peedrooh/seebum/production/seebum_2024-01-31_16-46-21/bom.csv

Designator | Footprint | Quantity | Value | LCSC Part #
C201, C204, C207 | 0805 | 3 | 10uF
C202, C205, C206 | 0805 | 3 | 0,1uF
C213, C214 | 0805 | 2 | 1uF
C215, C312 | 0805 | 2 | 100nF
C301, C302, C304, C306, C307, C308, C310, C311 | 0805 | 8 | 0.1uF
C303, C305 | CP_EIA-3528-21_Kemet-B | 2 | 10uF | C163225
C309 | 0805 | 1 | 2.2nF
C402 | 0805 | 1 | 22nF | C107137
C403, C411 | 0805 | 2 | 0u1F | C89258
C405, C406, C407, C408 | 0805 | 4 | 47uF | C7472975
C409, C410 | 1206 | 2 | 2u2F | C577211
D201 | 0805 | 1 | RED
D204, D205 | D_SOD-123 | 2 | D_Schottky | C2891704
D210 | 0805 | 1 | BLUE
D211 | 0805 | 1 | GREEN
D401 | D_PowerDI-5 | 1 | PDS760-13 | C96113
H101, H102, H103, H104 | MountingHole_2.7mm_M2.5_Pad_Via | 4 | MountingHole
J101 | AMASS_XT30PW-M_1x02_P2.50mm_Horizontal | 1 | Conn_01x02_Pin
J102 | PinHeader_2x03_P2.54mm_Vertical | 1 | Conn_01x06_Pin
J201, J202 | USB_C_Receptacle_G-Switch_GT-USB-7010ASV | 2 | USB_C_Receptacle_USB2.0
J301, J306 | JST_PH_B3B-PH-SM4-TB_1x03-1MP_P2.00mm_Vertical | 2 | Conn_01x03_Socket
J302, J304 | JST_PH_S2B-PH-SM4-TB_1x02-1MP_P2.00mm_Horizontal | 2 | Conn_01x02_Socket
J303, J305 | JST_PH_S6B-PH-SM4-TB_1x06-1MP_P2.00mm_Horizontal | 2 | Conn_01x06_Socket | C265405
J307 | JST_PH_B8B-PH-SM4-TB_1x08-1MP_P2.00mm_Vertical | 1 | Conn_01x08_Socket
J308 | JST_PH_B4B-PH-SM4-TB_1x04-1MP_P2.00mm_Vertical | 1 | Conn_01x04_Socket
J501 | PinSocket_2x20_P2.54mm_Vertical | 1 | GPIO
JP201, JP202 | SolderJumper-2_P1.3mm_Bridged_RoundedPad1.0x1.5mm | 2 | SolderJumper_2_Bridged
JP203, JP204, JP205, JP206, JP301 | SolderJumper-2_P1.3mm_Open_TrianglePad1.0x1.5mm | 5 | SolderJumper_2_Open
L401 | L_10.4x10.4_H4.8 | 1 | 8u2 | C2847563
Q101 | SO-8_5.3x6.2mm_P1.27mm | 1 | AO4407 | C469397
Q201, Q202 | SOT-23 | 2 | Q_NPN_BCE | C49581
R101 | 0805 | 1 | 2k | C17604
R102, R103, R104, R105, R301 | 0805 | 5 | 4k7
R201, R204, R205, R303 | 0805 | 4 | 1K
R202, R203 | 0805 | 2 | 10k
R212, R213, R214, R215 | 0805 | 4 | 5k1
R302 | 0805 | 1 | 330
R401 | 0805 | 1 | 84k5 | C17842
R402 | 0805 | 1 | 100k | C2763792
R403 | 0805 | 1 | 17k8 | C413729
SW101 | 5Amp_Switch | 1 | SW_DPDT_x2 | C2884744
SW201, SW202 | SW_SPST_B3U-1000P | 2 | SW_MEC_5E | C720477
U201 | SOT-223-3_TabPin2 | 1 | AMS1117-3.3
U202 | ESP32-S3-WROOM-1 | 1 | ESP32-S3-WROOM-1 | C2913205
U204 | TQFN-16-1EP_3x3mm_P0.5mm_EP1.23x1.23mm | 1 | CH343P | C2846043
U301, U302 | SSOP-24_5.3x8.2mm_P0.65mm | 2 | TB6612FNG
U303 | InvenSense_QFN-24_4x4mm_P0.5mm | 1 | MPU-6050
U304 | SOT-23-5 | 1 | 74LVC1G126 | C7834
U401 | Texas_R-PDSO-G8_EP2.95x4.9mm_Mask2.4x3.1mm_ThermalVias | 1 | LMR14050 | C155484
