peedrooh/seebum/3D Models/5Amp_Switch.stp

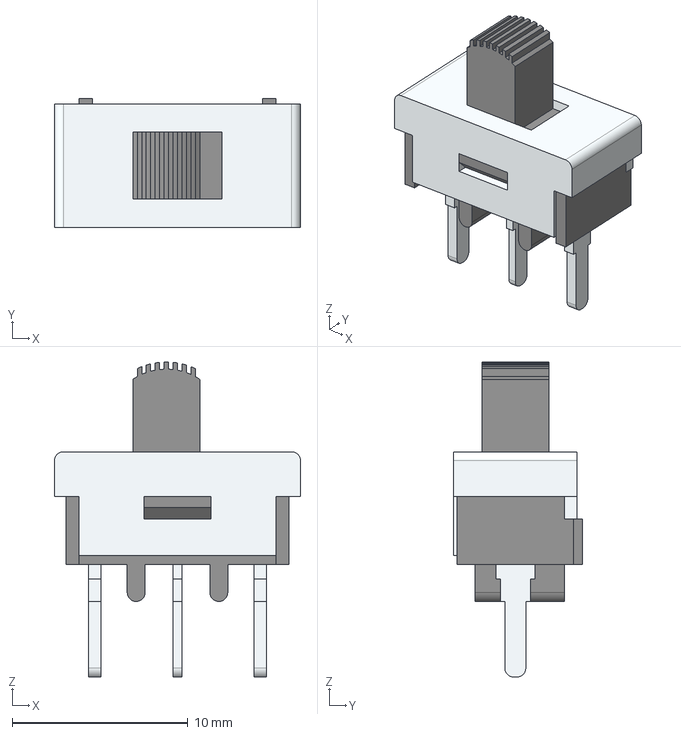
[picture p1: CAD file, 2024-02-03]
3D Models/5Amp_Switch.stp
14.0 x 7.32 x 17.9 mm
