peedrooh/seebum/3D Models/Amass_XT30PW-M_pcb solder.stp

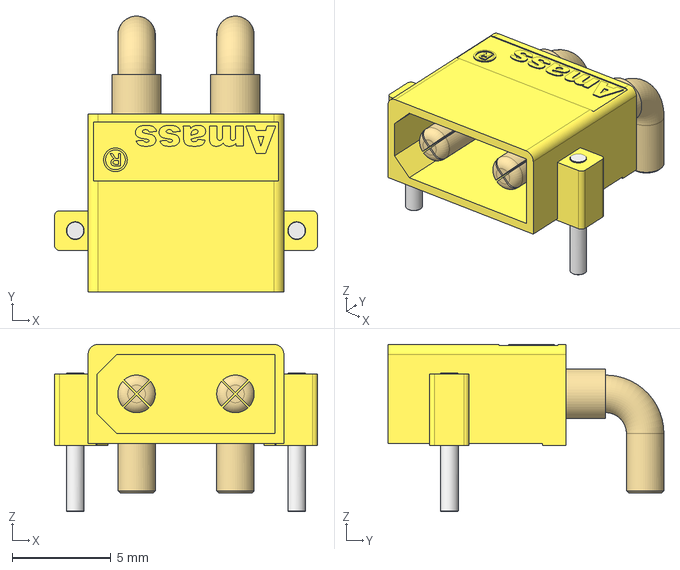
[picture p2: CAD file, 2024-02-03]
3D Models/Amass_XT30PW-M_pcb solder.stp
13.3 x 13.9 x 8.45 mm
