peedrooh/seebum/seebum.kicad_pcb

## KiCad design seebum.kicad_pcb (2024-02-03)

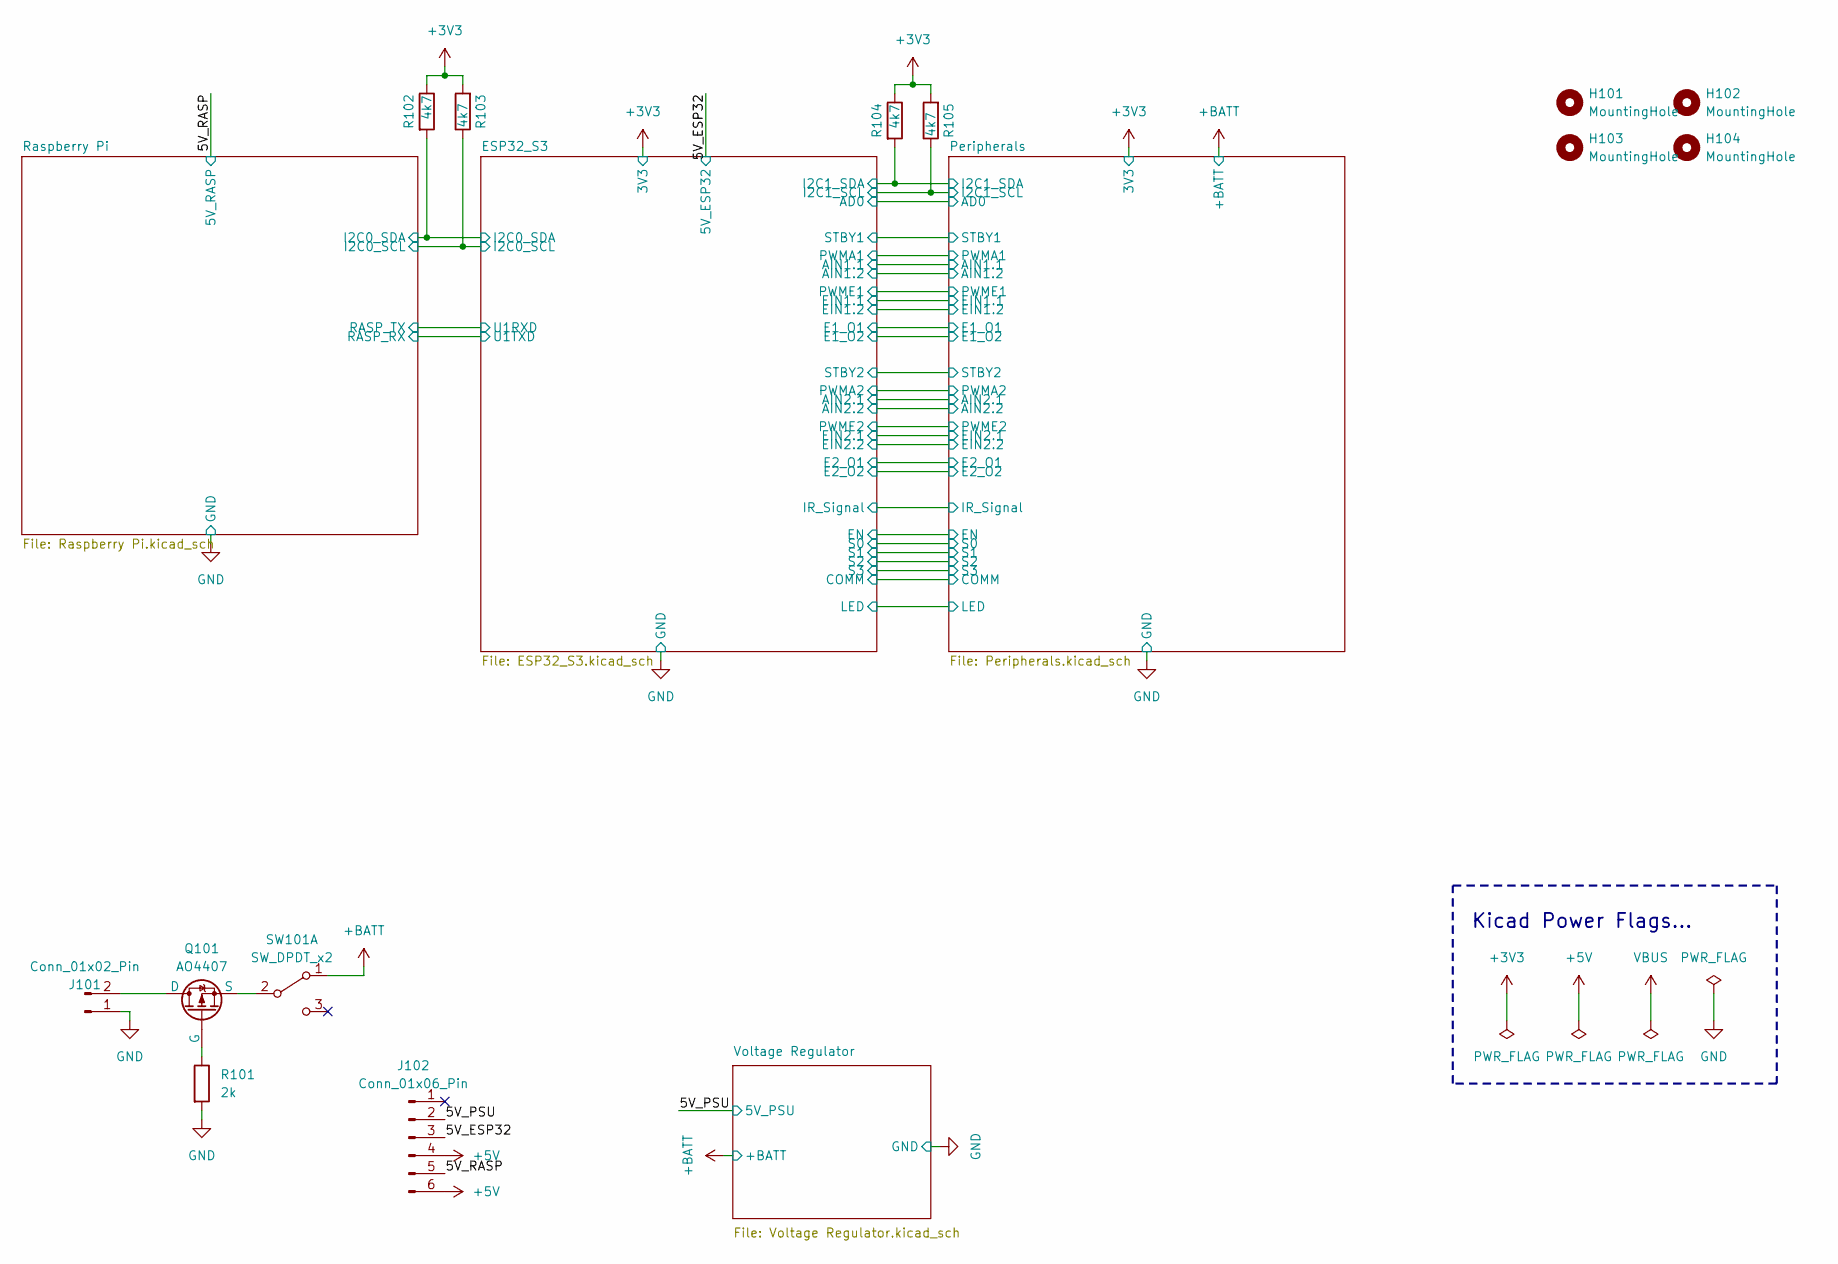
[picture p3: schematic seebum.kicad_sch]

Parts:
H101, H102, H103, H104: MountingHole; MountingHole_2.7mm_M2.5_Pad_Via
J101: Conn_01x02_Pin; AMASS_XT30PW-M_1x02_P2.50mm_Horizontal
J102: Conn_01x06_Pin; PinHeader_2x03_P2.54mm_Vertical
Q101: AO4407; SO-8_5.3x6.2mm_P1.27mm; LCSC C469397
R101: 2k; R_0805_2012Metric; LCSC C17604
R102, R103, R104, R105: 4k7; R_0805_2012Metric; LCSC C17673
SW101: SW_DPDT_x2; 5Amp_Switch; LCSC C2884744

Connections:
+3V3: R102.1, R103.2, R104.1, R105.2; also elsewhere on the board
+5V: J102.4, J102.6; also elsewhere on the board
+BATT: SW101.1 (A); also elsewhere on the board
/5V_ESP32: J102.3; also elsewhere on the board
/5V_PSU: J102.2; also elsewhere on the board
/5V_RASP: J102.5; also elsewhere on the board
/ESP32_S3/GPIO6: R102.2; also elsewhere on the board
/ESP32_S3/GPIO7: R103.1; also elsewhere on the board
/Peripherals/SCL: R105.1; also elsewhere on the board
/Peripherals/SDA: R104.2; also elsewhere on the board
GND: J101.1, R101.2; also elsewhere on the board
unnamed: J101.2, Q101.1 (D)
unnamed: Q101.2 (G), R101.1
unnamed: Q101.3 (S), SW101.2 (B)

Notes on the sheet:
Kicad Power Flags...

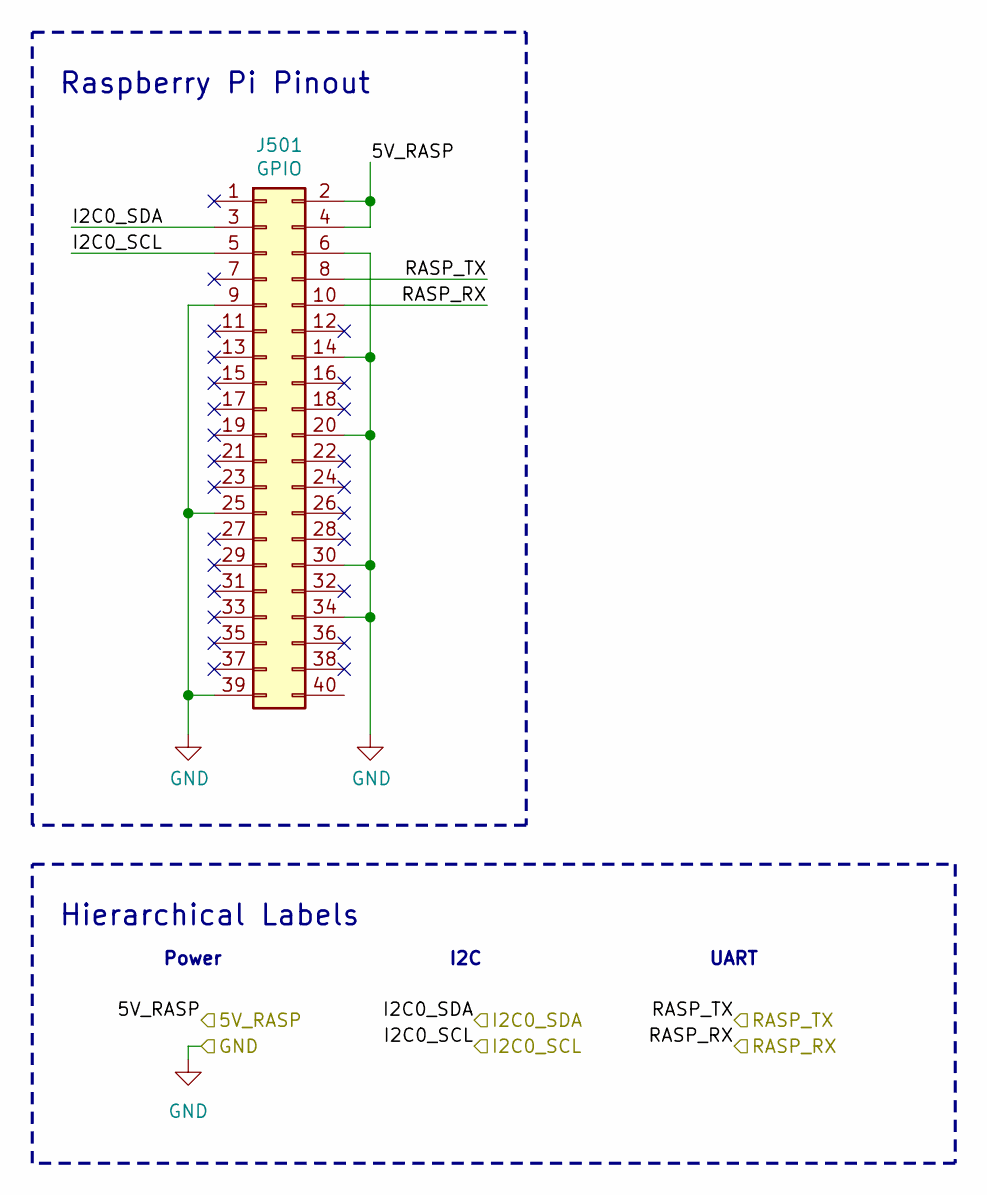
[picture p4: schematic Raspberry Pi.kicad_sch, Rapberry Pi]

Parts:
J501: GPIO; PinSocket_2x20_P2.54mm_Vertical

Connections:
/5V_RASP: J501.2, J501.4; also elsewhere on the board
/ESP32_S3/GPIO6: J501.3; also elsewhere on the board
/ESP32_S3/GPIO7: J501.5; also elsewhere on the board
/ESP32_S3/GPIO17: J501.10; also elsewhere on the board
/ESP32_S3/GPIO18: J501.8; also elsewhere on the board
GND: J501.6, J501.9, J501.14, J501.20, J501.25, J501.30, J501.34, J501.39; also elsewhere on the board

Notes on the sheet:
I2C
Hierarchical Labels
UART
Power
Raspberry Pi Pinout

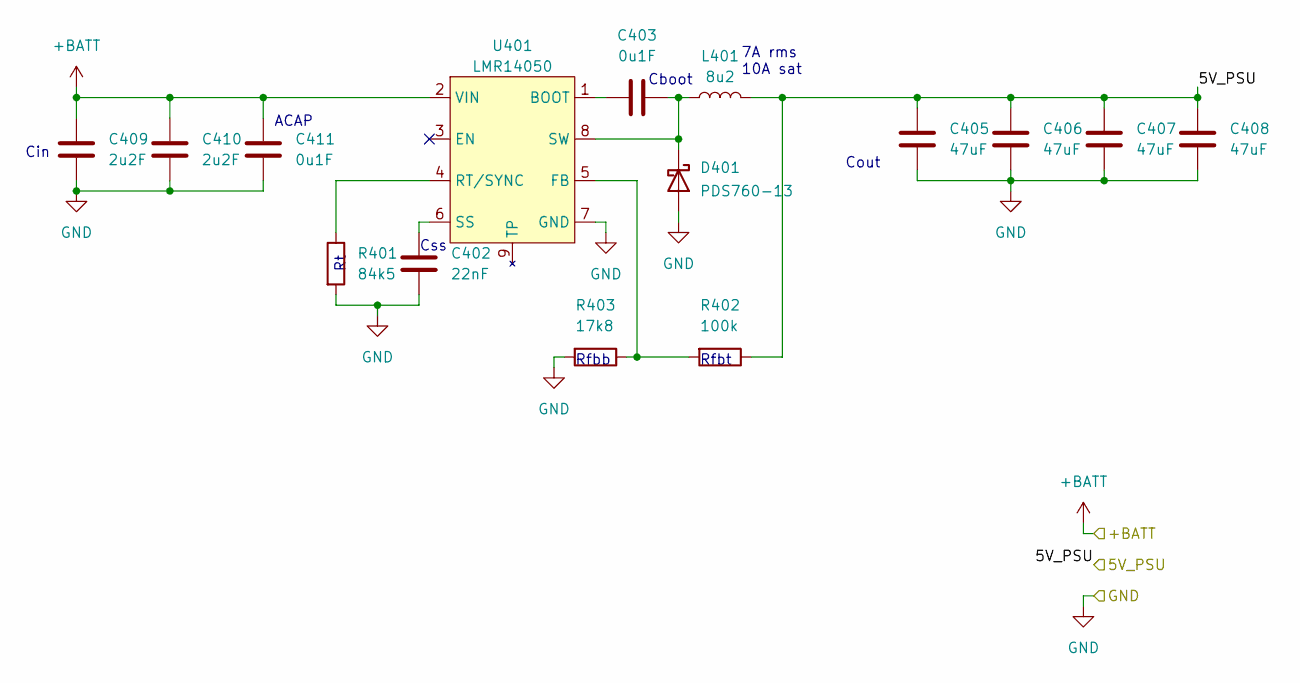
[picture p5: schematic Voltage Regulator.kicad_sch, Power Regulation]

Parts:
C402: 22nF; C_0805_2012Metric; LCSC C107137
C403, C411: 0u1F; C_0805_2012Metric; LCSC C89258
C405, C406, C407, C408: 47uF; C_0805_2012Metric; LCSC C7472975
C409, C410: 2u2F; C_1206_3216Metric; LCSC C577211
D401: PDS760-13; D_PowerDI-5; LCSC C96113
L401: 8u2; L_10.4x10.4_H4.8; LCSC C2847563
R401: 84k5; C_0805_2012Metric; LCSC C17842
R402: 100k; R_0805_2012Metric; LCSC C2763792
R403: 17k8; C_0805_2012Metric; LCSC C413729
U401: LMR14050; Texas_R-PDSO-G8_EP2.95x4.9mm_Mask2.4x3.1mm_ThermalVias; LCSC C155484

Connections:
+BATT: C409.1, C410.1, C411.1, U401.2 (VIN); also elsewhere on the board
/5V_PSU: C405.1, C406.1, C407.1, C408.1, L401.2, R402.1; also elsewhere on the board
GND: C402.2, C405.2, C406.2, C407.2, C408.2, C409.2, C410.2, C411.2, D401.2 (A), R401.2, R403.2, U401.7 (GND); also elsewhere on the board
unnamed: C403.2, D401.1 (K), L401.1, U401.8 (SW)
unnamed: C403.1, U401.1 (BOOT)
unnamed: R402.2, R403.1, U401.5 (FB)
unnamed: R401.1, U401.4 (RT/SYNC)
unnamed: C402.1, U401.6 (SS)

Notes on the sheet:
7A rms 10A sat
Cout
Cboot
ACAP
Cin
Css
Rfbt
Rfbb

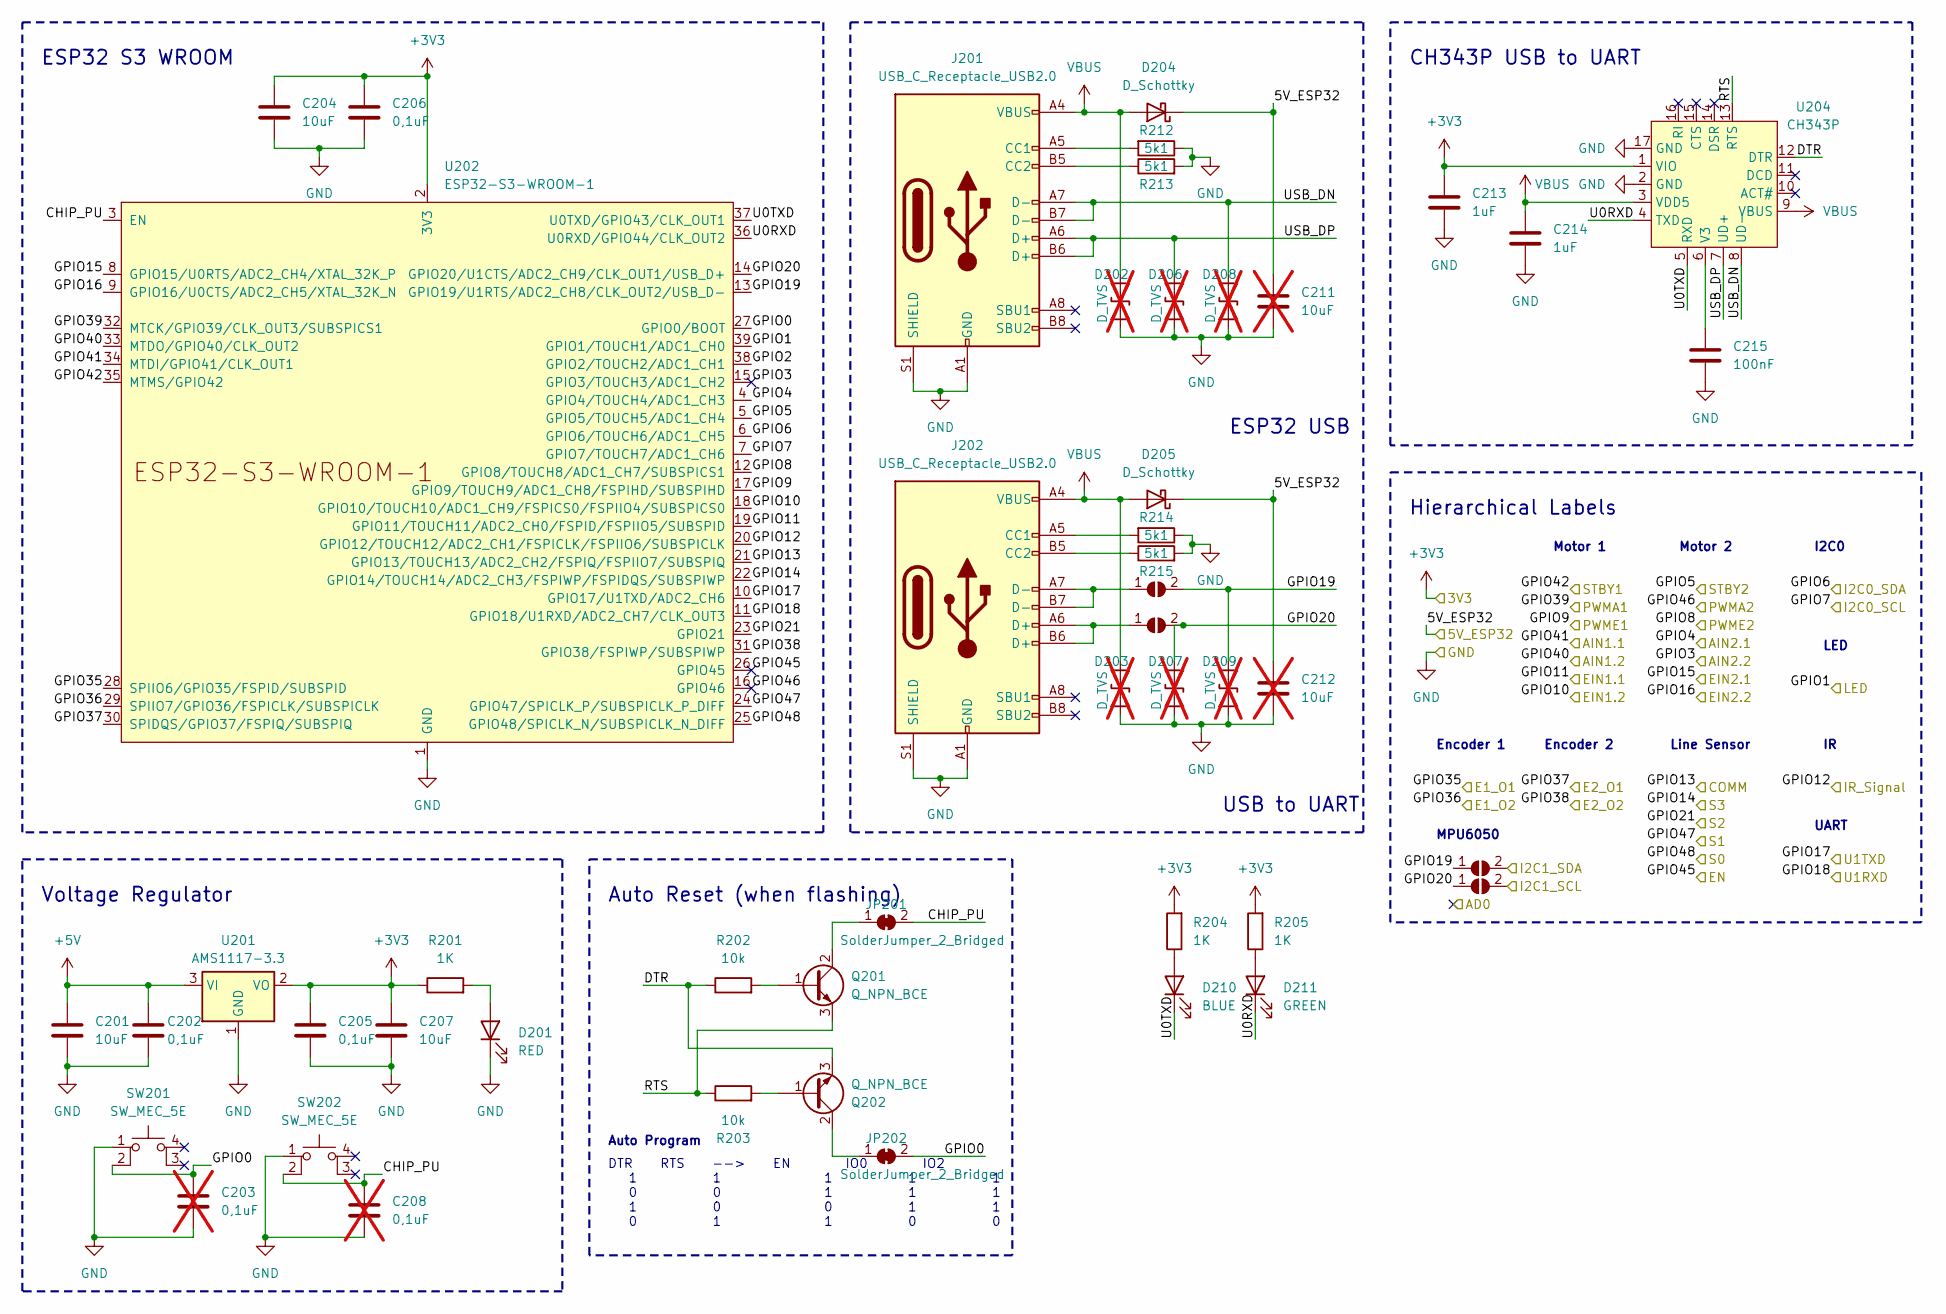
[picture p6: schematic ESP32_S3.kicad_sch, ESP32 S3]

Parts:
C201, C204, C207: 10uF; C_0805_2012Metric; LCSC C163225
C202, C205, C206: 0,1uF; C_0805_2012Metric; LCSC C38141
C203, C208: 0,1uF; C_0805_2012Metric; not fitted
C211, C212: 10uF; C_0805_2012Metric; not fitted
C213, C214: 1uF; C_0805_2012Metric; LCSC C28323
C215: 100nF; C_0805_2012Metric; LCSC C38141
D201: RED; LED_0805_2012Metric; LCSC C391863
D202, D203, D206, D207, D208, D209: D_TVS; D_SOD-523; LCSC C383211; not fitted
D204, D205: D_Schottky; D_SOD-123; LCSC C2891704
D210: BLUE; LED_0805_2012Metric; LCSC C205441
D211: GREEN; LED_0805_2012Metric; LCSC C84260
J201, J202: USB_C_Receptacle_USB2.0; USB_C_Receptacle_G-Switch_GT-USB-7010ASV; LCSC C2765186
JP201, JP202: SolderJumper_2_Bridged; SolderJumper-2_P1.3mm_Bridged_RoundedPad1.0x1.5mm
JP203, JP204, JP205, JP206: SolderJumper_2_Open; SolderJumper-2_P1.3mm_Open_TrianglePad1.0x1.5mm
Q201, Q202: Q_NPN_BCE; SOT-23; LCSC C49581
R201, R204, R205: 1K; R_0805_2012Metric; LCSC C17513
R202, R203: 10k; R_0805_2012Metric; LCSC C17414
R212, R213, R214, R215: 5k1; R_0805_2012Metric; LCSC C27834
SW201, SW202: SW_MEC_5E; SW_SPST_B3U-1000P; LCSC C720477
U201: AMS1117-3.3; SOT-223-3_TabPin2; LCSC C347222
U202: ESP32-S3-WROOM-1; LCSC C2913205
U204: CH343P; TQFN-16-1EP_3x3mm_P0.5mm_EP1.23x1.23mm; LCSC C2846043

Connections:
+3V3: C204.1, C205.1, C206.1, C207.1, C213.1, R201.1, R204.2, R205.2, U201.2 (VO), U202.2 (3V3), U204.1 (VIO); also elsewhere on the board
+5V: C201.1, C202.1, U201.3 (VI); also elsewhere on the board
/5V_ESP32: C211.1, C212.1, D204.1 (K), D205.1 (K); also elsewhere on the board
/ESP32_S3/CHIP_PU: C208.1, JP201.2 (B), SW202.2, U202.3 (EN)
/ESP32_S3/DTR: Q202.3 (E), R202.1, U204.12 (DTR)
/ESP32_S3/GPIO0: C203.1, JP202.2 (B), SW201.2, U202.27 (GPIO0/BOOT)
/ESP32_S3/GPIO1: U202.39 (GPIO1/TOUCH1/ADC1_CH0); also elsewhere on the board
/ESP32_S3/GPIO2: U202.38 (GPIO2/TOUCH2/ADC1_CH1)
/ESP32_S3/GPIO3: U202.15 (GPIO3/TOUCH3/ADC1_CH2); also elsewhere on the board
/ESP32_S3/GPIO4: U202.4 (GPIO4/TOUCH4/ADC1_CH3); also elsewhere on the board
/ESP32_S3/GPIO5: U202.5 (GPIO5/TOUCH5/ADC1_CH4); also elsewhere on the board
/ESP32_S3/GPIO6: U202.6 (GPIO6/TOUCH6/ADC1_CH5); also elsewhere on the board
/ESP32_S3/GPIO7: U202.7 (GPIO7/TOUCH7/ADC1_CH6); also elsewhere on the board
/ESP32_S3/GPIO8: U202.12 (GPIO8/TOUCH8/ADC1_CH7/SUBSPICS1); also elsewhere on the board
/ESP32_S3/GPIO9: U202.17 (GPIO9/TOUCH9/ADC1_CH8/FSPIHD/SUBSPIHD); also elsewhere on the board
/ESP32_S3/GPIO10: U202.18 (GPIO10/TOUCH10/ADC1_CH9/FSPICS0/FSPIIO4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); also elsewhere on the board
/ESP32_S3/GPIO11: U202.19 (GPIO11/TOUCH11/ADC2_CH0/FSPID/FSPIIO5/S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); also elsewhere on the board
/ESP32_S3/GPIO12: U202.20 (GPIO12/TOUCH12/ADC2_CH1/FSPICLK/FSPIIO6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); also elsewhere on the board
/ESP32_S3/GPIO13: U202.21 (GPIO13/TOUCH13/ADC2_CH2/FSPIQ/FSPIIO7/S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); also elsewhere on the board
/ESP32_S3/GPIO14: U202.22 (GPIO14/TOUCH14/ADC2_CH3/FSPIWP/FSPIDQS/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); also elsewhere on the board
/ESP32_S3/GPIO15: U202.8 (GPIO15/U0RTS/ADC2_CH4/XTAL_32K_P); also elsewhere on the board
/ESP32_S3/GPIO16: U202.9 (GPIO16/U0CTS/ADC2_CH5/XTAL_32K_N); also elsewhere on the board
/ESP32_S3/GPIO17: U202.10 (GPIO17/U1TXD/ADC2_CH6); also elsewhere on the board
/ESP32_S3/GPIO18: U202.11 (GPIO18/U1RXD/ADC2_CH7/CLK_OUT3); also elsewhere on the board
/ESP32_S3/GPIO19: D209.2 (A2), JP203.2 (B), JP205.1 (A), U202.13 (GPIO19/U1RTS/ADC2_CH8/CLK_OUT2/USB_D-)
/ESP32_S3/GPIO20: D207.1 (A1), JP204.2 (B), JP206.1 (A), U202.14 (GPIO20/U1CTS/ADC2_CH9/CLK_OUT1/USB_D+)
/ESP32_S3/GPIO21: U202.23 (GPIO21); also elsewhere on the board
/ESP32_S3/GPIO35: U202.28 (SPIIO6/GPIO35/FSPID/SUBSPID); also elsewhere on the board
/ESP32_S3/GPIO36: U202.29 (SPIIO7/GPIO36/FSPICLK/SUBSPICLK); also elsewhere on the board
/ESP32_S3/GPIO37: U202.30 (SPIDQS/GPIO37/FSPIQ/SUBSPIQ); also elsewhere on the board
/ESP32_S3/GPIO38: U202.31 (GPIO38/FSPIWP/SUBSPIWP); also elsewhere on the board
/ESP32_S3/GPIO39: U202.32 (MTCK/GPIO39/CLK_OUT3/SUBSPICS1); also elsewhere on the board
/ESP32_S3/GPIO40: U202.33 (MTDO/GPIO40/CLK_OUT2); also elsewhere on the board
/ESP32_S3/GPIO41: U202.34 (MTDI/GPIO41/CLK_OUT1); also elsewhere on the board
/ESP32_S3/GPIO42: U202.35 (MTMS/GPIO42); also elsewhere on the board
/ESP32_S3/GPIO45: U202.26 (GPIO45); also elsewhere on the board
/ESP32_S3/GPIO46: U202.16 (GPIO46); also elsewhere on the board
/ESP32_S3/GPIO47: U202.24 (GPIO47/SPICLK_P/SUBSPICLK_P_DIFF); also elsewhere on the board
/ESP32_S3/GPIO48: U202.25 (GPIO48/SPICLK_N/SUBSPICLK_N_DIFF); also elsewhere on the board
/ESP32_S3/RTS: Q201.3 (E), R203.1, U204.13 (RTS)
/ESP32_S3/U0RXD: D211.1 (K), U202.36 (U0RXD/GPIO44/CLK_OUT2), U204.4 (TXD)
/ESP32_S3/U0TXD: D210.1 (K), U202.37 (U0TXD/GPIO43/CLK_OUT1), U204.5 (RXD)
/ESP32_S3/USB_DN: D208.2 (A2), J201.A7 (D-), J201.B7 (D-), U204.8 (UD-)
/ESP32_S3/USB_DP: D206.1 (A1), J201.A6 (D+), J201.B6 (D+), U204.7 (UD+)
/Peripherals/SCL: JP206.2 (B); also elsewhere on the board
/Peripherals/SDA: JP205.2 (B); also elsewhere on the board
GND: C201.2, C202.2, C203.2, C204.2, C205.2, C206.2, C207.2, C208.2, C211.2, C212.2, C213.2, C214.2, C215.2, D201.1 (K), D202.1 (A1), D203.1 (A1), D206.2 (A2), D207.2 (A2), D208.1 (A1), D209.1 (A1), J201.A1 (GND), J201.A12 (GND), J201.B1 (GND), J201.B12 (GND), J201.S1 (SHIELD), J202.A1 (GND), J202.A12 (GND), J202.B1 (GND), J202.B12 (GND), J202.S1 (SHIELD), R212.1, R213.2, R214.1, R215.2, SW201.1, SW202.1, U201.1 (GND), U202.1 (GND), U202.40 (GND), U202.41 (GND), U204.2 (GND), U204.17 (GND); also elsewhere on the board
unnamed: D201.2 (A), R201.2
unnamed: D210.2 (A), R204.1
unnamed: D211.2 (A), R205.1
unnamed: J201.A5 (CC1), R212.2
unnamed: J201.B5 (CC2), R213.1
unnamed: J202.A5 (CC1), R214.2
unnamed: J202.B5 (CC2), R215.1
unnamed: JP201.1 (A), Q201.2 (C)
unnamed: JP202.1 (A), Q202.2 (C)
unnamed: J202.A7 (D-), J202.B7 (D-), JP203.1 (A)
unnamed: J202.A6 (D+), J202.B6 (D+), JP204.1 (A)
unnamed: Q201.1 (B), R202.2
unnamed: Q202.1 (B), R203.2
unnamed: C215.1, U204.6 (V3)
VBUS: C214.1, D202.2 (A2), D203.2 (A2), D204.2 (A), D205.2 (A), J201.A4 (VBUS), J201.A9 (VBUS), J201.B4 (VBUS), J201.B9 (VBUS), J202.A4 (VBUS), J202.A9 (VBUS), J202.B4 (VBUS), J202.B9 (VBUS), U204.3 (VDD5), U204.9 (VBUS)

Notes on the sheet:
Voltage Regulator
ESP32 S3 WROOM
DTR RTS --> EN IO0 IO2 1 1 1 1 1 0 0 1 1 1 1 0 0 1 1 0 1 1 0 0
MPU6050
Motor 1
Auto Program
Line Sensor
USB to UART
UART
Encoder 1
ESP32 USB
Auto Reset (when flashing)
CH343P USB to UART
Hierarchical Labels
Encoder 2
Motor 2
I2C0
LED

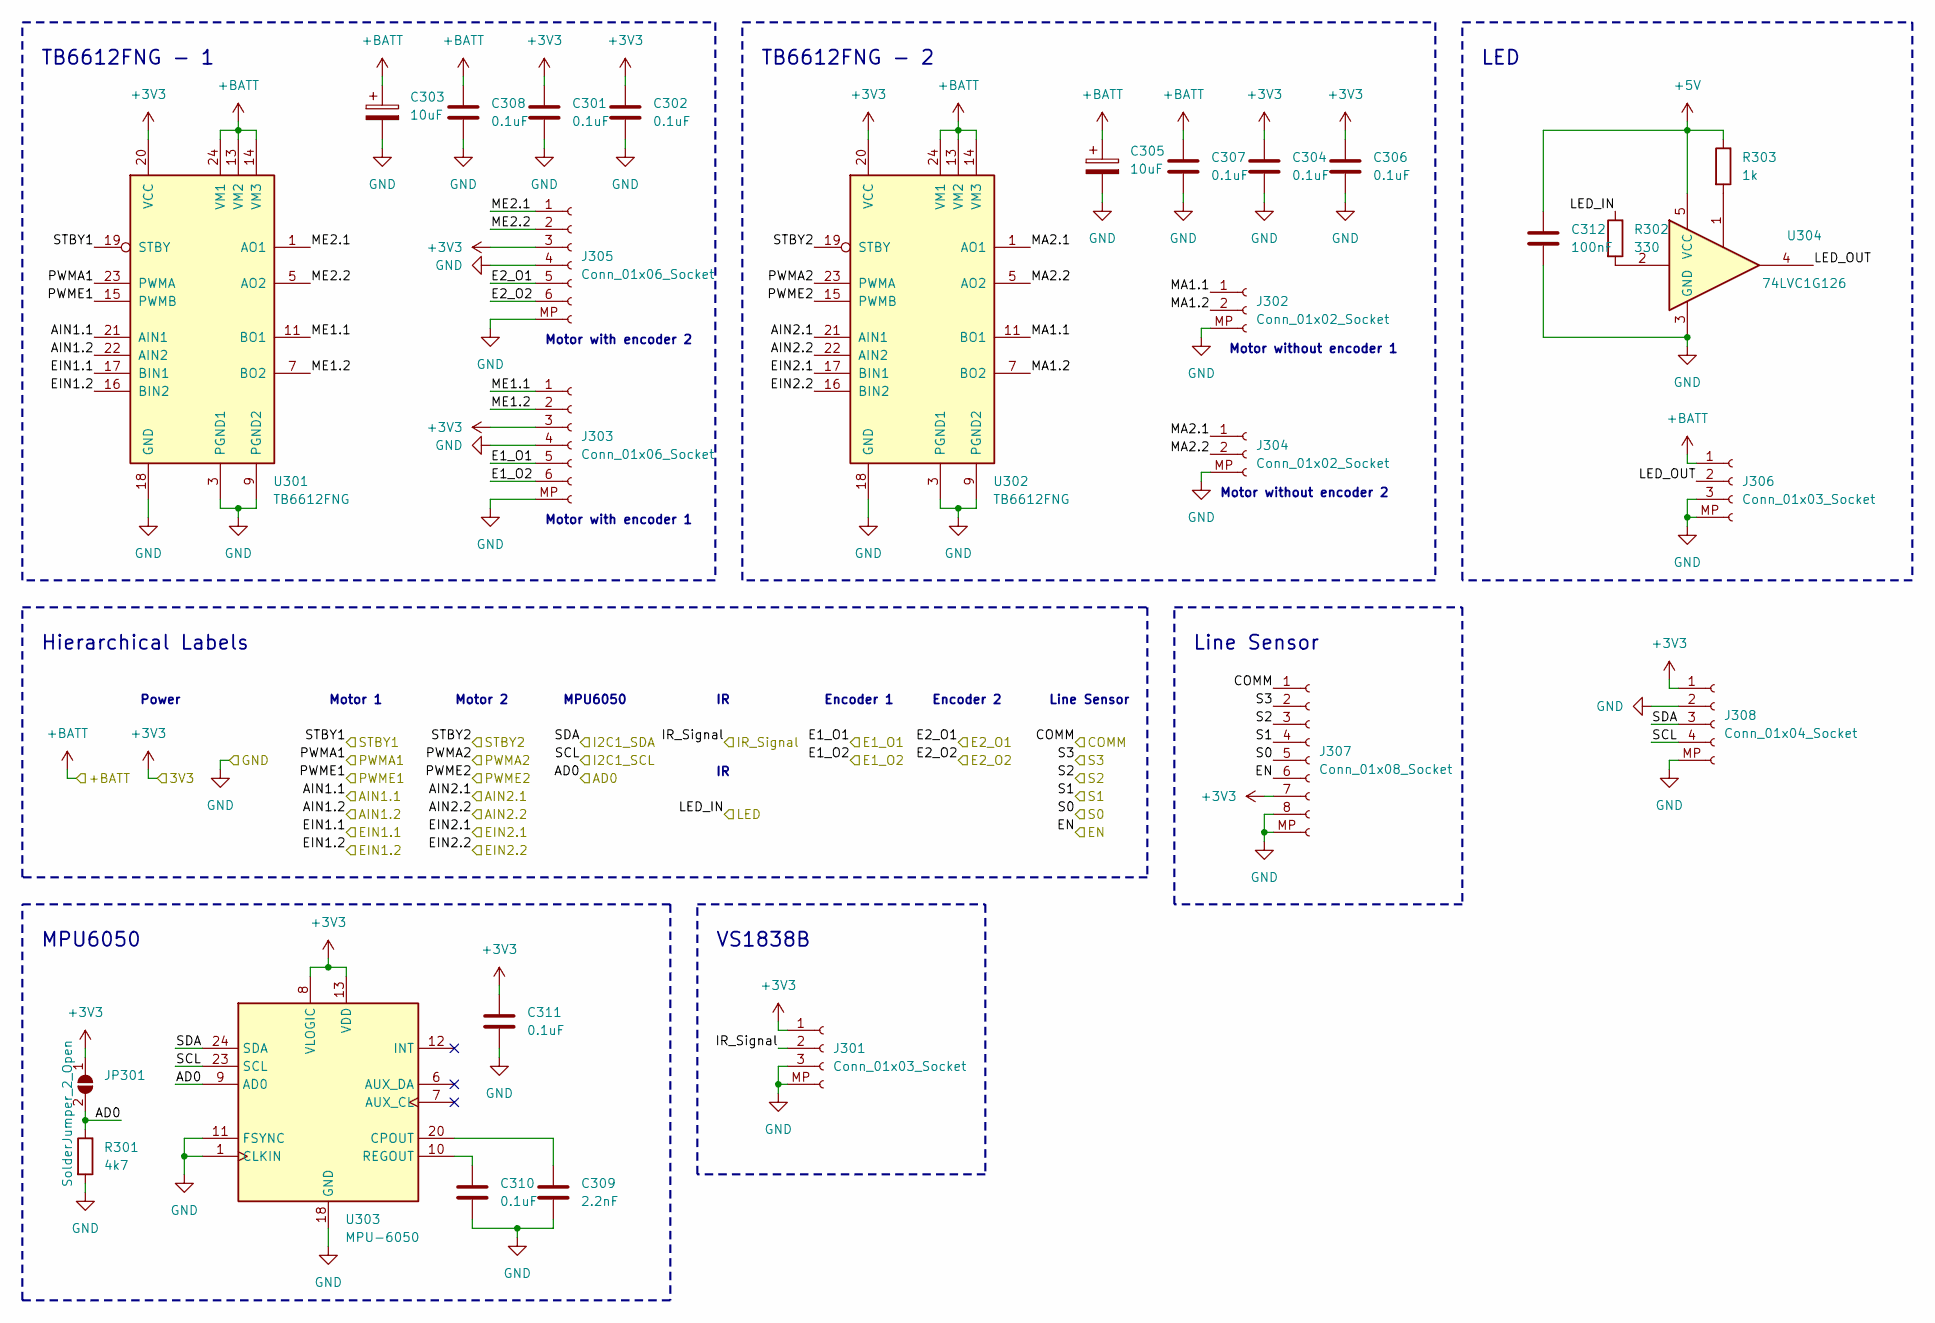
[picture p7: schematic Peripherals.kicad_sch]

Parts:
C301, C302, C304, C306, C307, C308, C310, C311: 0.1uF; C_0805_2012Metric; LCSC C38141
C303, C305: 10uF; CP_EIA-3528-21_Kemet-B; LCSC C163225
C309: 2.2nF; C_0805_2012Metric; LCSC C36576
C312: 100nF; C_0805_2012Metric; LCSC C38141
J301, J306: Conn_01x03_Socket; JST_PH_B3B-PH-SM4-TB_1x03-1MP_P2.00mm_Vertical; LCSC C160353
J302, J304: Conn_01x02_Socket; JST_PH_S2B-PH-SM4-TB_1x02-1MP_P2.00mm_Horizontal; LCSC C295747
J303, J305: Conn_01x06_Socket; JST_PH_S6B-PH-SM4-TB_1x06-1MP_P2.00mm_Horizontal; LCSC C265405
J307: Conn_01x08_Socket; JST_PH_B8B-PH-SM4-TB_1x08-1MP_P2.00mm_Vertical; LCSC C157915
J308: Conn_01x04_Socket; JST_PH_B4B-PH-SM4-TB_1x04-1MP_P2.00mm_Vertical
JP301: SolderJumper_2_Open; SolderJumper-2_P1.3mm_Open_TrianglePad1.0x1.5mm
R301: 4k7; R_0805_2012Metric; LCSC C17673
R302: 330; R_0805_2012Metric; LCSC C17630
R303: 1k; R_0805_2012Metric; LCSC C17513
U301, U302: TB6612FNG; SSOP-24_5.3x8.2mm_P0.65mm; LCSC C88224
U303: MPU-6050; InvenSense_QFN-24_4x4mm_P0.5mm; LCSC C24112
U304: 74LVC1G126; SOT-23-5; LCSC C7834

Connections:
+3V3: C301.1, C302.1, C304.1, C306.1, C311.1, J301.1, J303.3, J305.3, J307.7, J308.1, JP301.1 (A), U301.20 (VCC), U302.20 (VCC), U303.8 (VLOGIC), U303.13 (VDD); also elsewhere on the board
+5V: C312.1, R303.1, U304.5 (VCC); also elsewhere on the board
+BATT: C303.1, C305.1, C307.1, C308.1, J306.1, U301.13 (VM2), U301.14 (VM3), U301.24 (VM1), U302.13 (VM2), U302.14 (VM3), U302.24 (VM1); also elsewhere on the board
/ESP32_S3/GPIO1: R302.1; also elsewhere on the board
/ESP32_S3/GPIO3: U302.22 (AIN2); also elsewhere on the board
/ESP32_S3/GPIO4: U302.21 (AIN1); also elsewhere on the board
/ESP32_S3/GPIO5: U302.19 (STBY); also elsewhere on the board
/ESP32_S3/GPIO8: U302.15 (PWMB); also elsewhere on the board
/ESP32_S3/GPIO9: U301.15 (PWMB); also elsewhere on the board
/ESP32_S3/GPIO10: U301.16 (BIN2); also elsewhere on the board
/ESP32_S3/GPIO11: U301.17 (BIN1); also elsewhere on the board
/ESP32_S3/GPIO12: J301.2; also elsewhere on the board
/ESP32_S3/GPIO13: J307.1; also elsewhere on the board
/ESP32_S3/GPIO14: J307.2; also elsewhere on the board
/ESP32_S3/GPIO15: U302.17 (BIN1); also elsewhere on the board
/ESP32_S3/GPIO16: U302.16 (BIN2); also elsewhere on the board
/ESP32_S3/GPIO21: J307.3; also elsewhere on the board
/ESP32_S3/GPIO35: J303.5; also elsewhere on the board
/ESP32_S3/GPIO36: J303.6; also elsewhere on the board
/ESP32_S3/GPIO37: J305.5; also elsewhere on the board
/ESP32_S3/GPIO38: J305.6; also elsewhere on the board
/ESP32_S3/GPIO39: U301.23 (PWMA); also elsewhere on the board
/ESP32_S3/GPIO40: U301.22 (AIN2); also elsewhere on the board
/ESP32_S3/GPIO41: U301.21 (AIN1); also elsewhere on the board
/ESP32_S3/GPIO42: U301.19 (STBY); also elsewhere on the board
/ESP32_S3/GPIO45: J307.6; also elsewhere on the board
/ESP32_S3/GPIO46: U302.23 (PWMA); also elsewhere on the board
/ESP32_S3/GPIO47: J307.4; also elsewhere on the board
/ESP32_S3/GPIO48: J307.5; also elsewhere on the board
/Peripherals/AD0: JP301.2 (B), R301.1, U303.9 (AD0)
/Peripherals/LED_OUT: J306.2, U304.4
/Peripherals/MA1.1: J302.1, U302.11 (BO1), U302.12 (BO1)
/Peripherals/MA1.2: J302.2, U302.7 (BO2), U302.8 (BO2)
/Peripherals/MA2.1: J304.1, U302.1 (AO1), U302.2 (AO1)
/Peripherals/MA2.2: J304.2, U302.5 (AO2), U302.6 (AO2)
/Peripherals/ME1.1: J303.1, U301.11 (BO1), U301.12 (BO1)
/Peripherals/ME1.2: J303.2, U301.7 (BO2), U301.8 (BO2)
/Peripherals/ME2.1: J305.1, U301.1 (AO1), U301.2 (AO1)
/Peripherals/ME2.2: J305.2, U301.5 (AO2), U301.6 (AO2)
/Peripherals/SCL: J308.4, U303.23 (SCL); also elsewhere on the board
/Peripherals/SDA: J308.3, U303.24 (SDA); also elsewhere on the board
GND: C301.2, C302.2, C303.2, C304.2, C305.2, C306.2, C307.2, C308.2, C309.2, C310.2, C311.2, C312.2, J301.3, J301.MP (Pin_4), J302.MP (Pin_3), J303.4, J303.MP (Pin_7), J304.MP (Pin_3), J305.4, J305.MP (Pin_7), J306.3, J306.MP (Pin_4), J307.8, J307.MP (Pin_9), J308.2, J308.MP (Pin_5), R301.2, U301.3 (PGND1), U301.4 (PGND1), U301.9 (PGND2), U301.10 (PGND2), U301.18 (GND), U302.3 (PGND1), U302.4 (PGND1), U302.9 (PGND2), U302.10 (PGND2), U302.18 (GND), U303.1 (CLKIN), U303.11 (FSYNC), U303.18 (GND), U304.3 (GND); also elsewhere on the board
unnamed: R302.2, U304.2
unnamed: R303.2, U304.1
unnamed: C309.1, U303.20 (CPOUT)
unnamed: C310.1, U303.10 (REGOUT)

Notes on the sheet:
MPU6050
Motor without encoder 1
Line Sensor
Motor 2
Hierarchical Labels
Motor 1
Encoder 1
Motor without encoder 2
Motor with encoder 2
TB6612FNG - 2
TB6612FNG - 1
Encoder 2
Power
LED
VS1838B
Motor with encoder 1

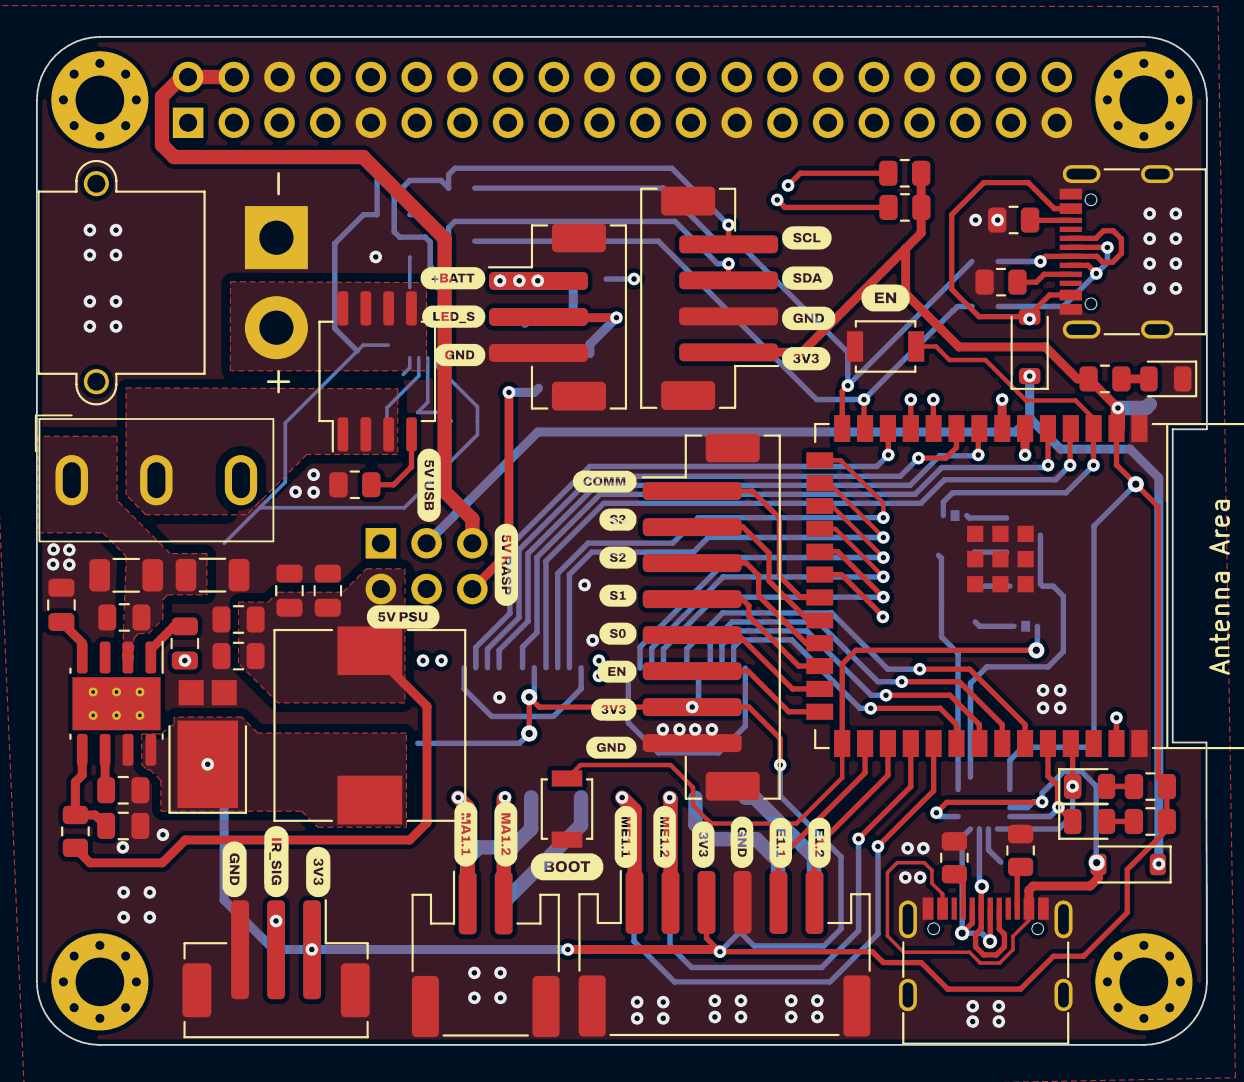
[picture p8: board seebum.kicad_pcb from above]

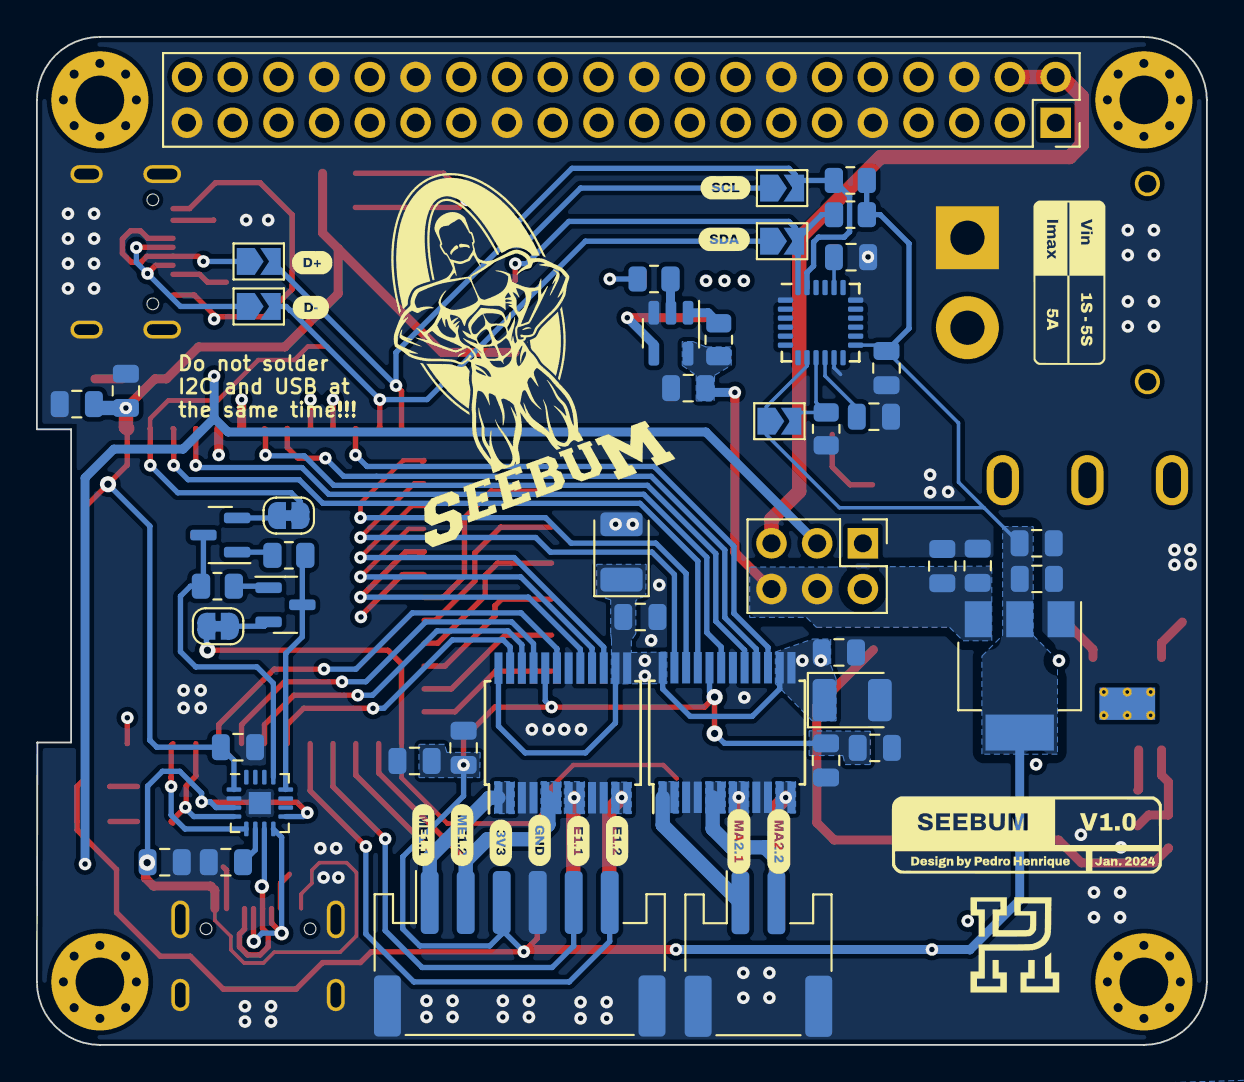
[picture p9: board seebum.kicad_pcb from below]

Board: 4 copper layers, 65.0 x 56.0 mm, 95 parts (47 on the bottom side), 86 nets.
